cyfinfaza/WINLAB-LP-Radio-Sensor-Hub/WINLAB-LP-Radio-Sensor-Hub-Top-Orthographic.png

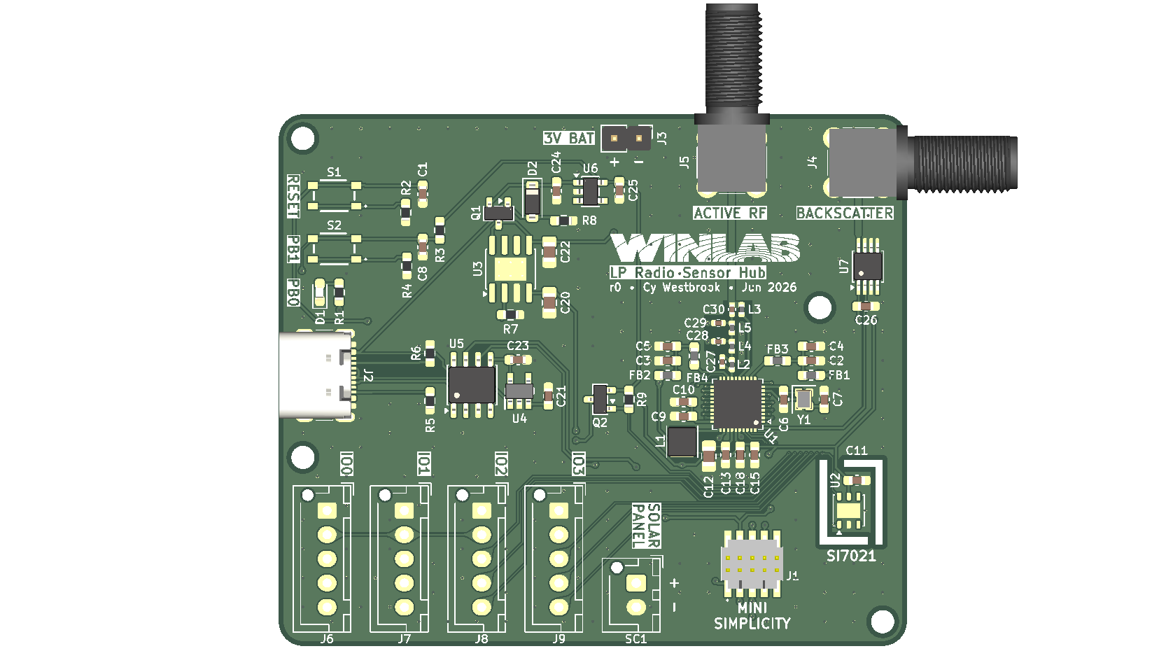
WINLAB-LP-Radio-Sensor-Hub-Top-Orthographic.png
