cyfinfaza/WINLAB-LP-Radio-Sensor-Hub/JLCPCB-BOM.xls

Comment | Designator | Footprint | JLCPCB Part #
1.3n | L4 | 0402 | C97996
470n | C3 | 0603 | C1623
4.7u | C12,C22 | 0805 | C1779
1.5n | L2 | 0402 | C395055
22u | C20 | 0805 | C45783
ADG902BRMZ | U7 | MSOP-8_3x3mm_P0.65mm | C207407
36k | R7,R8,R9 | 0603 | C23147
100n | C1,C11,C13,C15,C26,C8,C9, C17, C19 | 0603 | C14663
FTSH-105-01-L-DV-K-A | J1 | FTSH-105-XX-YYY-DV-K-A | C21221592
100p | C4,C5 | 0603 | C14858
12p | C6,C7 | 0603 | C38523
18n | L3 | 0402 | C86060
AO3401A | Q1,Q2 | SOT-23 | C15127
LED | D1 | 0603 | C2290
13n | L5 | 0402 | C2991840
39MHz10pF | Y1 | Crystal_SMD_2016-4Pin_2.0x1.6mm | C5360883
USB_C_Receptacle_USB2.0_16P | J2 | USB_C_Receptacle_GCT_USB4105-xx-A_16P_TopMnt_Horizontal | C165948
FerriteBead | FB1,FB2,FB3,FB4 | 0603 | C88984
1.9p | C27 | 0402 | C161314
1.3p | C29 | 0402 | C161309
CH340N | U5 | JEITA_SOIC-8_3.9x4.9mm_P1.27mm | C2977777
CN3063 | U3 | SOIC-8-1EP_3.9x4.9mm_P1.27mm_EP2.41x3.3mm_ThermalVias | C28078
5.1k | R5,R6 | 0603 | C23186
220p | C30 | 0402 | C1530
100 | R2,R4 | 0603 | C22775
TPS7A0522PDBV | U6 | SOT-23-5 | C2863529
7.2p | C28 | 0402 | C2220960
1u | C10,C18,C2,C21,C23,C24,C25, C14, C16 | 0603 | C15849
1N4148W | D2 | D_SOD-123 | C81598
10k | R3 | 0603 | C25804
2.2u | L1 | L_APV_ANR3015 | C6364793
470 | R1 | 0603 | C23179
SMA | J4,J5 | SMA | C7542042
Tactile Switch | S1,S2 | RKB2SJK250SMTRLFS | C2927789
TLV74033PDBVR | U4 | TLV74033PDBVR | C3743587
