cyfinfaza/WINLAB-LP-Radio-Sensor-Hub/WINLAB-LP-Radio-Sensor-Hub.kicad_pcb

## KiCad design WINLAB-LP-Radio-Sensor-Hub.kicad_pcb (2026-09-07)

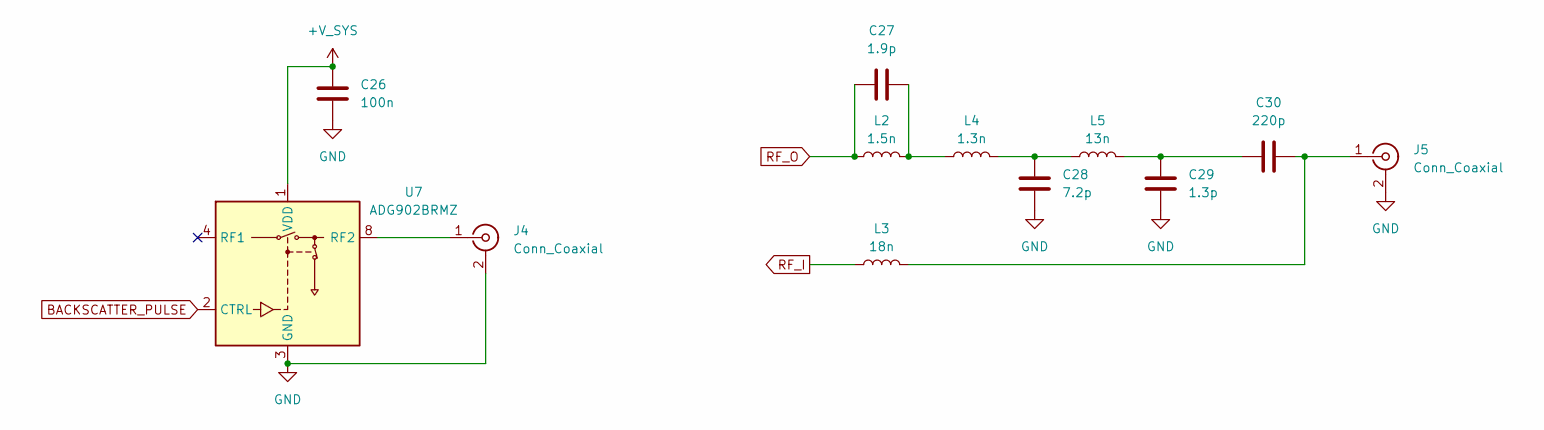
[picture p6: schematic RF.kicad_sch]

Parts:
C26: 100n; C_0603_1608Metric_Pad1.08x0.95mm_HandSolder
C27: 1.9p; C_0402_1005Metric
C28: 7.2p; C_0402_1005Metric
C29: 1.3p; C_0402_1005Metric
C30: 220p; C_0402_1005Metric
J4, J5: Conn_Coaxial; SMA_Molex_73251-2200_Horizontal
L2: 1.5n; L_0402_1005Metric
L3: 18n; L_0402_1005Metric
L4: 1.3n; L_0402_1005Metric
L5: 13n; L_0402_1005Metric
U7: ADG902BRMZ; MSOP-8_3x3mm_P0.65mm

Connections:
+V_SYS: C26.1, U7.1 (VDD); also elsewhere on the board
BACKSCATTER_PULSE: U7.2 (CTRL); also elsewhere on the board
GND: C26.2, C28.2, C29.2, J4.2 (Ext), J5.2 (Ext), U7.3 (GND), U7.5 (GND), U7.6 (GND), U7.7 (GND); also elsewhere on the board
unnamed: C27.2, L2.2, L4.1
unnamed: C28.1, L4.2, L5.1
unnamed: C29.1, C30.1, L5.2
unnamed: J4.1 (In), U7.8 (RF2)
unnamed: C30.2, J5.1 (In), L3.2
RF_I: L3.1; also elsewhere on the board
RF_O: C27.1, L2.1; also elsewhere on the board

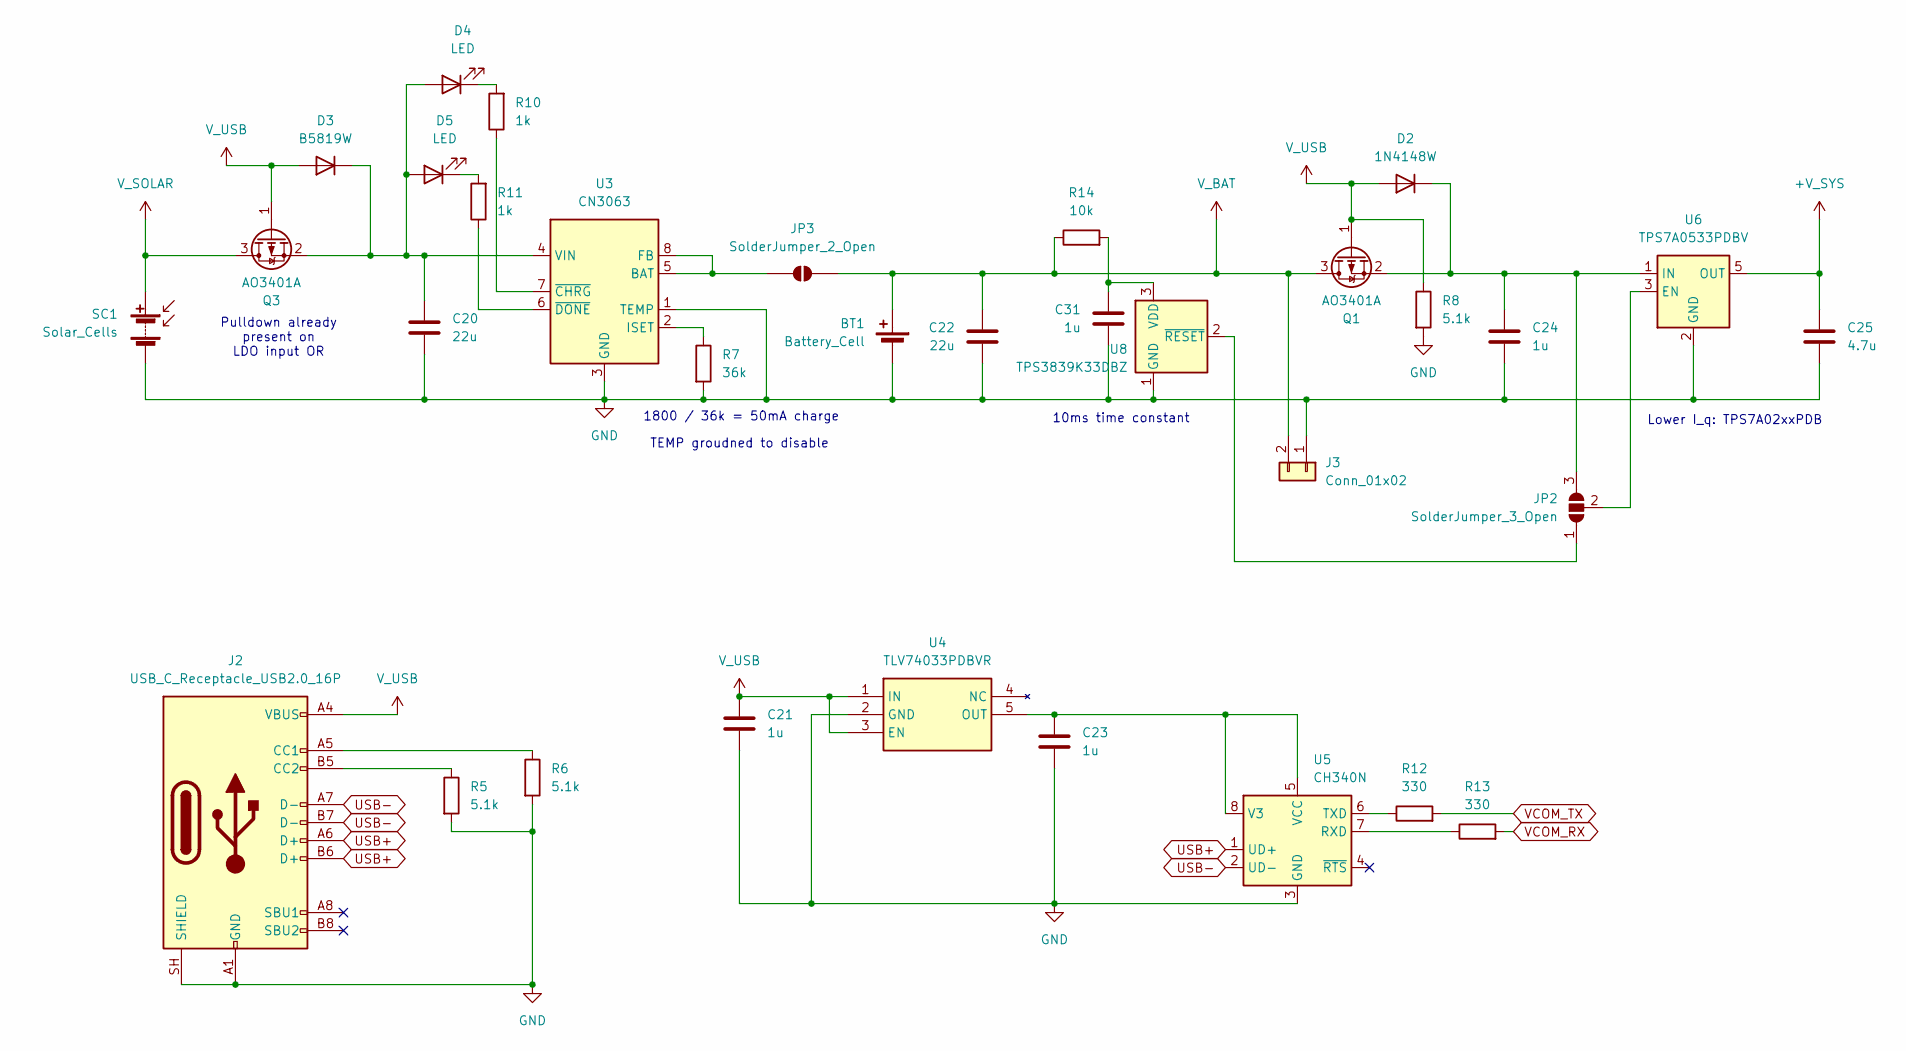
[picture p7: schematic Power.kicad_sch]

Parts:
BT1: Battery_Cell; BatteryHolder_Keystone_3008_1x2450
C20, C22: 22u; C_0805_2012Metric_Pad1.18x1.45mm_HandSolder
C21, C23, C24, C31: 1u; C_0603_1608Metric_Pad1.08x0.95mm_HandSolder
C25: 4.7u; C_0805_2012Metric_Pad1.18x1.45mm_HandSolder
D2: 1N4148W; D_SOD-123
D3: B5819W; D_SOD-123
D4, D5: LED; LED_0603_1608Metric_Pad1.05x0.95mm_HandSolder
J2: USB_C_Receptacle_USB2.0_16P; USB_C_Receptacle_GCT_USB4105-xx-A_16P_TopMnt_Horizontal
J3: Conn_01x02; PinHeader_1x02_P2.54mm_Vertical
JP2: SolderJumper_3_Open; SolderJumper-3_P1.3mm_Open_RoundedPad1.0x1.5mm
JP3: SolderJumper_2_Open; SolderJumper-2_P1.3mm_Open_RoundedPad1.0x1.5mm
Q1, Q3: AO3401A; SOT-23
R5, R6, R8: 5.1k; R_0603_1608Metric_Pad0.98x0.95mm_HandSolder
R7: 36k; R_0603_1608Metric_Pad0.98x0.95mm_HandSolder
R10, R11: 1k; R_0603_1608Metric_Pad0.98x0.95mm_HandSolder
R12, R13: 330; R_0603_1608Metric_Pad0.98x0.95mm_HandSolder
R14: 10k; R_0603_1608Metric_Pad0.98x0.95mm_HandSolder
SC1: Solar_Cells; JST_XH_B2B-XH-AM_1x02_P2.50mm_Vertical
U3: CN3063; SOIC-8-1EP_3.9x4.9mm_P1.27mm_EP2.41x3.3mm_ThermalVias
U4: TLV74033PDBVR; SOT95P280X145-5N; Mouser Part Number 595-TLV74033PDBVR
U5: CH340N; JEITA_SOIC-8_3.9x4.9mm_P1.27mm
U6: TPS7A0533PDBV; SOT-23-5
U8: TPS3839K33DBZ; SOT-23

Connections:
+V_SYS: C25.1, U6.5 (OUT); also elsewhere on the board
GND: BT1.2 (-), C20.2, C21.2, C22.2, C23.2, C24.2, C25.2, C31.2, J2.A1 (GND), J2.A12 (GND), J2.B1 (GND), J2.B12 (GND), J2.SH (SHIELD), J3.1, R5.2, R6.2, R7.2, R8.2, SC1.2 (-), U3.1 (TEMP), U3.3 (GND), U3.9 (GND), U4.2 (GND), U5.3 (GND), U6.2 (GND), U8.1 (GND); also elsewhere on the board
unnamed: C24.1, D2.1 (K), JP2.3 (B), Q1.2 (S), U6.1 (IN)
unnamed: C20.1, D3.1 (K), D4.2 (A), D5.2 (A), Q3.2 (S), U3.4 (VIN)
unnamed: D4.1 (K), R10.2
unnamed: D5.1 (K), R11.2
unnamed: J2.A5 (CC1), R6.1
unnamed: J2.B5 (CC2), R5.1
unnamed: JP2.1 (A), U8.2 (~RESET)
unnamed: JP2.2 (C), U6.3 (EN)
unnamed: JP3.1 (A), U3.5 (BAT), U3.8 (FB)
unnamed: R7.1, U3.2 (ISET)
unnamed: R10.1, U3.7 (~CHRG)
unnamed: R11.1, U3.6 (~DONE)
unnamed: C23.1, U4.5 (OUT), U5.5 (VCC), U5.8 (V3)
unnamed: R13.1, U5.7 (RXD)
unnamed: R12.1, U5.6 (TXD)
unnamed: C31.1, R14.2, U8.3 (VDD)
USB+: J2.A6 (D+), J2.B6 (D+), U5.1 (UD+)
USB-: J2.A7 (D-), J2.B7 (D-), U5.2 (UD-)
VCOM_RX: R13.2; also elsewhere on the board
VCOM_TX: R12.2; also elsewhere on the board
V_BAT: BT1.1 (+), C22.1, J3.2, JP3.2 (B), Q1.3 (D), R14.1
V_SOLAR: Q3.3 (D), SC1.1 (+)
V_USB: C21.1, D2.2 (A), D3.2 (A), J2.A4 (VBUS), J2.A9 (VBUS), J2.B4 (VBUS), J2.B9 (VBUS), Q1.1 (G), Q3.1 (G), R8.1, U4.1 (IN), U4.3 (EN)

Notes on the sheet:
Pulldown already present on LDO input OR
1800 / 36k = 50mA charge
Lower I_q: TPS7A02xxPDB
10ms time constant
TEMP groudned to disable

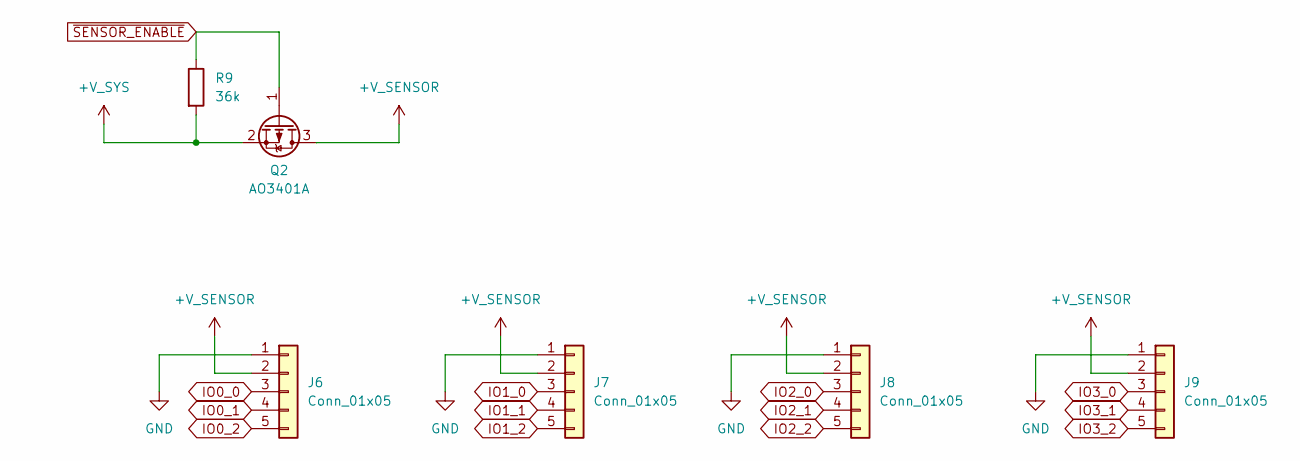
[picture p8: schematic IO.kicad_sch]

Parts:
J6, J7, J8, J9: Conn_01x05; JST_XH_B5B-XH-AM_1x05_P2.50mm_Vertical
Q2: AO3401A; SOT-23
R9: 36k; R_0603_1608Metric_Pad0.98x0.95mm_HandSolder

Connections:
+V_SENSOR: J6.2, J7.2, J8.2, J9.2, Q2.3 (D)
+V_SYS: Q2.2 (S), R9.2; also elsewhere on the board
GND: J6.1, J7.1, J8.1, J9.1; also elsewhere on the board
IO0_0: J6.3; also elsewhere on the board
IO0_1: J6.4; also elsewhere on the board
IO0_2: J6.5; also elsewhere on the board
IO1_0: J7.3; also elsewhere on the board
IO1_1: J7.4; also elsewhere on the board
IO1_2: J7.5; also elsewhere on the board
IO2_0: J8.3; also elsewhere on the board
IO2_1: J8.4; also elsewhere on the board
IO2_2: J8.5; also elsewhere on the board
IO3_0: J9.3; also elsewhere on the board
IO3_1: J9.4; also elsewhere on the board
IO3_2: J9.5; also elsewhere on the board
~SENSOR_ENABLE: Q2.1 (G), R9.1; also elsewhere on the board

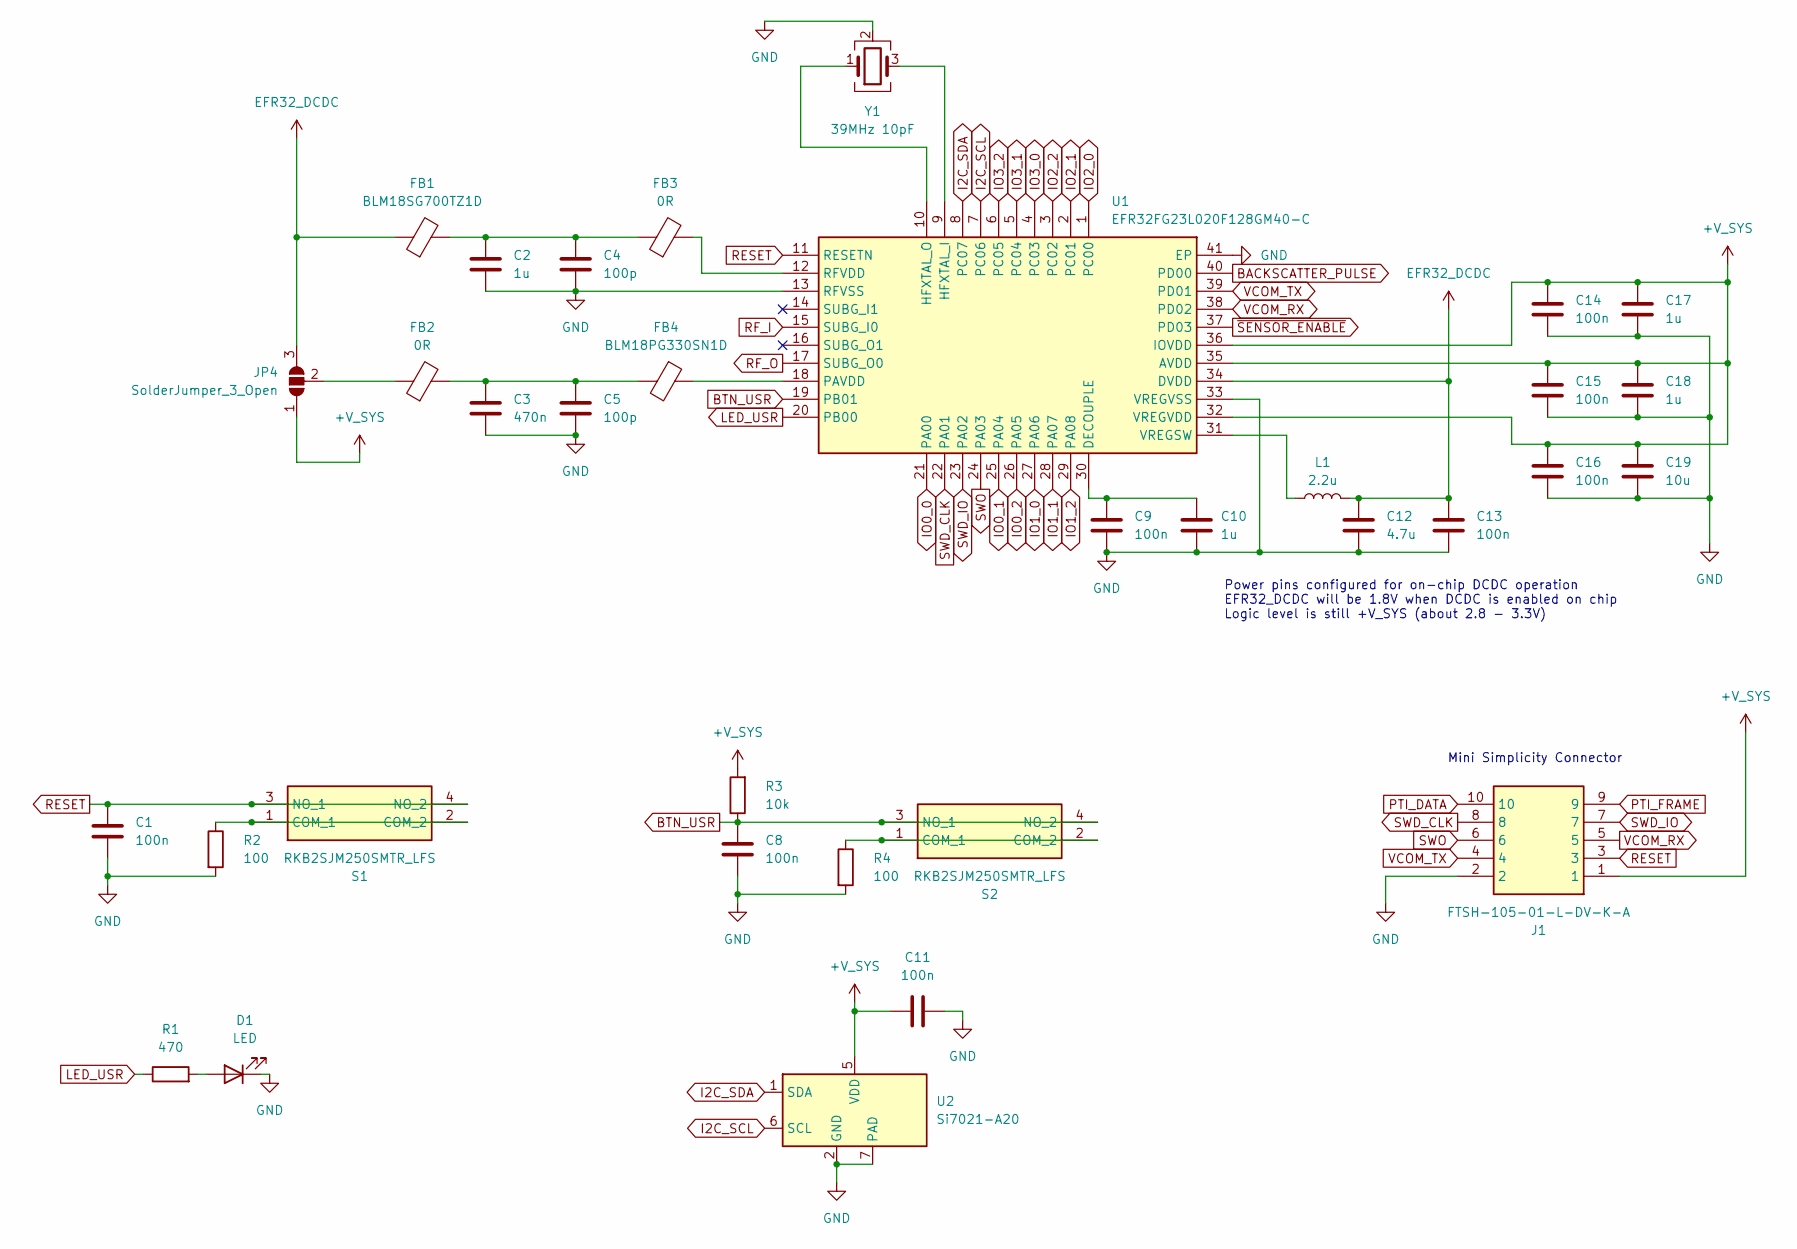
[picture p9: schematic MCU.kicad_sch]

Parts:
C1, C8, C9, C11, C13, C14, C15, C16: 100n; C_0603_1608Metric_Pad1.08x0.95mm_HandSolder
C2, C10, C17, C18: 1u; C_0603_1608Metric_Pad1.08x0.95mm_HandSolder
C3: 470n; C_0603_1608Metric_Pad1.08x0.95mm_HandSolder
C4, C5: 100p; C_0603_1608Metric_Pad1.08x0.95mm_HandSolder
C12: 4.7u; C_0805_2012Metric_Pad1.18x1.45mm_HandSolder
C19: 10u; C_0603_1608Metric_Pad1.08x0.95mm_HandSolder
D1: LED; LED_0603_1608Metric_Pad1.05x0.95mm_HandSolder
FB1: BLM18SG700TZ1D; L_0603_1608Metric_Pad1.05x0.95mm_HandSolder
FB2, FB3: 0R; L_0603_1608Metric_Pad1.05x0.95mm_HandSolder
FB4: BLM18PG330SN1D; L_0603_1608Metric_Pad1.05x0.95mm_HandSolder
J1: FTSH-105-01-L-DV-K-A; FTSH-105-XX-YYY-DV-K-A; Mouser Part Number 200-FTSH10501LDVKA
JP4: SolderJumper_3_Open; SolderJumper-3_P1.3mm_Open_RoundedPad1.0x1.5mm
L1: 2.2u; L_APV_ANR3015
R1: 470; R_0603_1608Metric_Pad0.98x0.95mm_HandSolder
R2, R4: 100; R_0603_1608Metric_Pad0.98x0.95mm_HandSolder
R3: 10k; R_0603_1608Metric_Pad0.98x0.95mm_HandSolder
S1, S2: RKB2SJM250SMTR_LFS; RKB2SJM250SMTRLFS; Mouser Part Number 611-RKB2SJM250SMTRLF
U1: EFR32FG23L020F128GM40-C; QFN-40-1EP_5x5mm_P0.4mm_EP3.6x3.6mm; Manufacturer_Part_Number EFR32FG23L020F128GM40-C
U2: Si7021-A20; DFN-6-1EP_3x3mm_P1mm_EP1.5x2.4mm
Y1: 39MHz 10pF; Crystal_SMD_2016-4Pin_2.0x1.6mm

Connections:
+V_SYS: C11.1, C14.1, C15.1, C16.1, C17.1, C18.1, C19.1, J1.1, JP4.1 (A), R3.2, U1.32 (VREGVDD), U1.35 (AVDD), U1.36 (IOVDD), U2.5 (VDD); also elsewhere on the board
BACKSCATTER_PULSE: U1.40 (PD00); also elsewhere on the board
BTN_USR: C8.1, R3.1, S2.3 (NO_1), S2.4 (NO_2), U1.19 (PB01)
EFR32_DCDC: C12.1, C13.1, FB1.1, JP4.3 (B), L1.2, U1.34 (DVDD)
GND: C1.2, C2.2, C3.2, C4.2, C5.2, C8.2, C9.2, C10.2, C11.2, C12.2, C13.2, C14.2, C15.2, C16.2, C17.2, C18.2, C19.2, D1.1 (K), J1.2, R2.2, R4.2, U1.13 (RFVSS), U1.33 (VREGVSS), U1.41 (EP), U2.2 (GND), U2.7 (PAD), Y1.2 (G), Y1.4 (G); also elsewhere on the board
I2C_SCL: U1.7 (PC06), U2.6 (SCL)
I2C_SDA: U1.8 (PC07), U2.1 (SDA)
IO0_0: U1.21 (PA00); also elsewhere on the board
IO0_1: U1.25 (PA04); also elsewhere on the board
IO0_2: U1.26 (PA05); also elsewhere on the board
IO1_0: U1.27 (PA06); also elsewhere on the board
IO1_1: U1.28 (PA07); also elsewhere on the board
IO1_2: U1.29 (PA08); also elsewhere on the board
IO2_0: U1.1 (PC00); also elsewhere on the board
IO2_1: U1.2 (PC01); also elsewhere on the board
IO2_2: U1.3 (PC02); also elsewhere on the board
IO3_0: U1.4 (PC03); also elsewhere on the board
IO3_1: U1.5 (PC04); also elsewhere on the board
IO3_2: U1.6 (PC05); also elsewhere on the board
LED_USR: R1.1, U1.20 (PB00)
unnamed: C2.1, C4.1, FB1.2, FB3.1
unnamed: C3.1, C5.1, FB2.2, FB4.2
unnamed: D1.2 (A), R1.2
unnamed: FB2.1, JP4.2 (C)
unnamed: R2.1, S1.1 (COM_1), S1.2 (COM_2)
unnamed: R4.1, S2.1 (COM_1), S2.2 (COM_2)
unnamed: C9.1, C10.1, U1.30 (DECOUPLE)
unnamed: U1.9 (HFXTAL_I), Y1.3
unnamed: U1.10 (HFXTAL_O), Y1.1
unnamed: FB4.1, U1.18 (PAVDD)
unnamed: FB3.2, U1.12 (RFVDD)
unnamed: L1.1, U1.31 (VREGSW)
PTI_DATA: J1.10
PTI_FRAME: J1.9
RESET: C1.1, J1.3, S1.3 (NO_1), S1.4 (NO_2), U1.11 (RESETN)
RF_I: U1.15 (SUBG_I0); also elsewhere on the board
RF_O: U1.17 (SUBG_O0); also elsewhere on the board
SWD_CLK: J1.8, U1.22 (PA01)
SWD_IO: J1.7, U1.23 (PA02)
SWO: J1.6, U1.24 (PA03)
VCOM_RX: J1.5, U1.38 (PD02); also elsewhere on the board
VCOM_TX: J1.4, U1.39 (PD01); also elsewhere on the board
~SENSOR_ENABLE: U1.37 (PD03); also elsewhere on the board

Notes on the sheet:
Power pins configured for on-chip DCDC operation EFR32_DCDC will be 1.8V when DCDC is enabled on chip Logic level is still +V_SYS (about 2.8 - 3.3V)
Mini Simplicity Connector

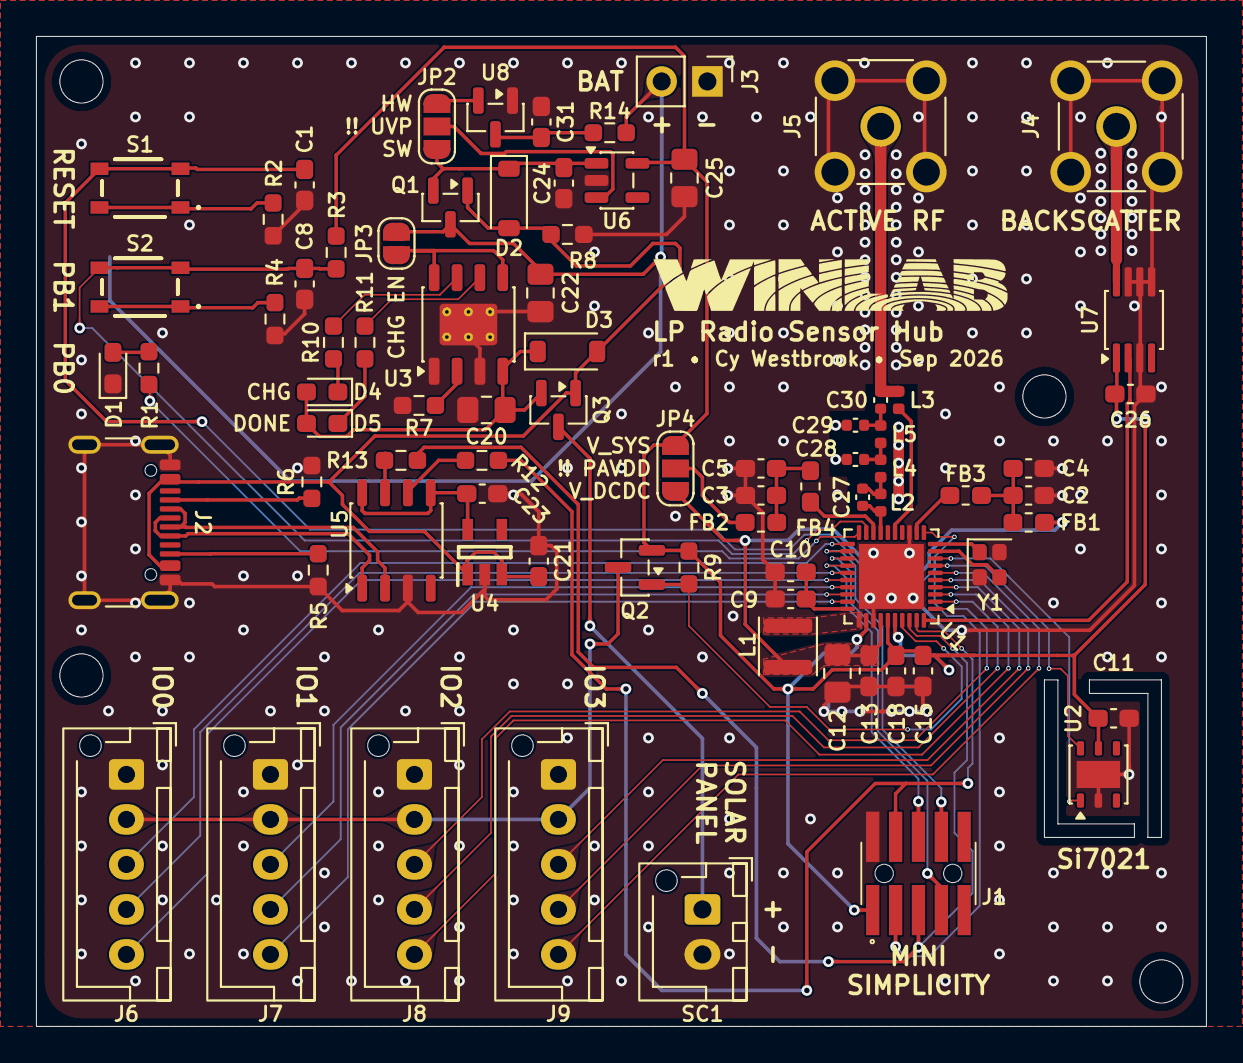
[picture p10: board WINLAB-LP-Radio-Sensor-Hub.kicad_pcb from above]

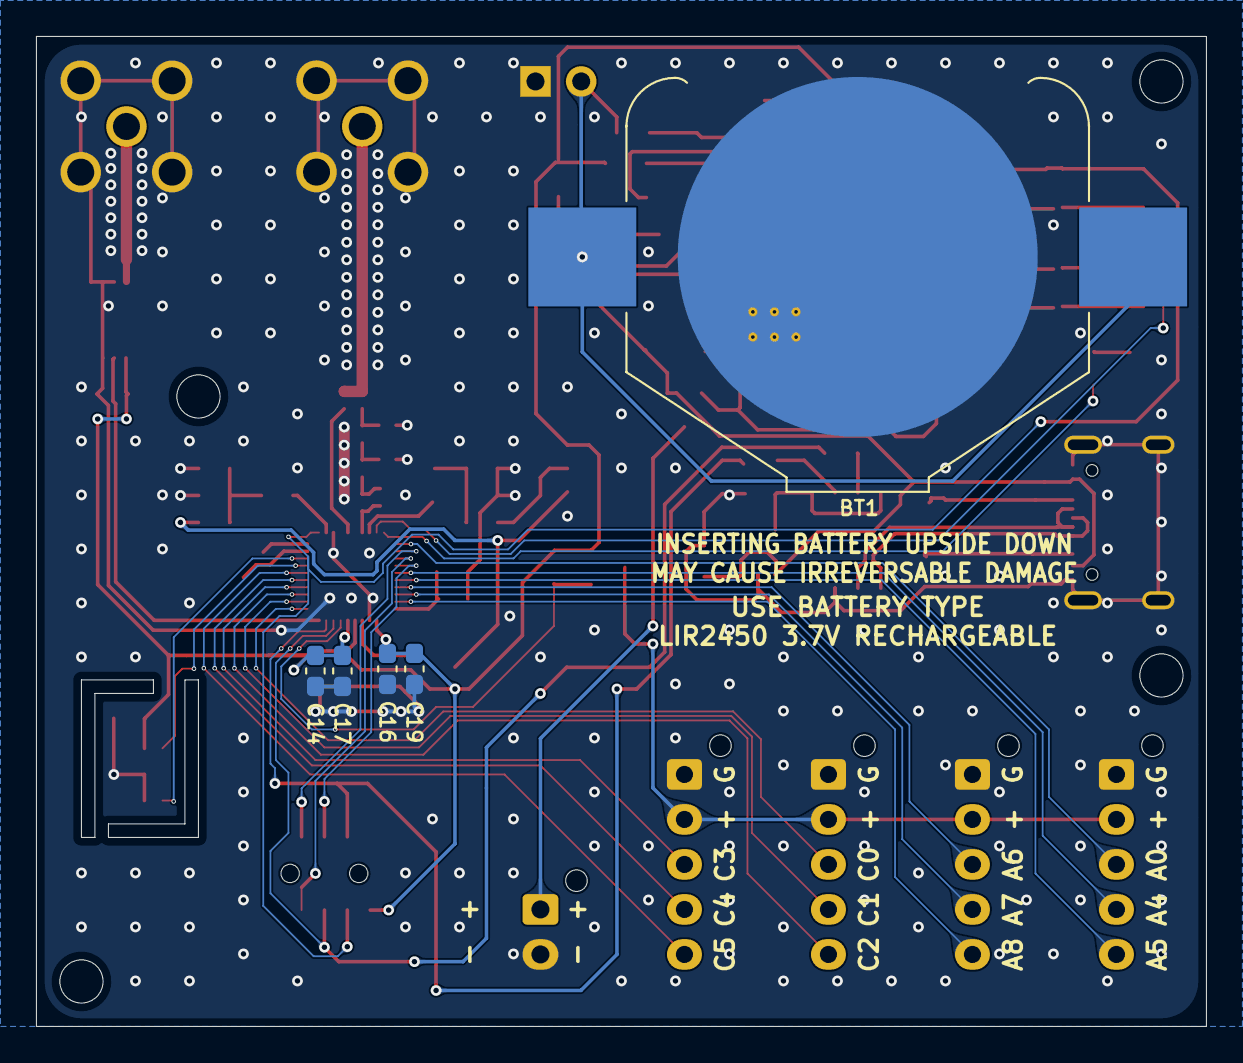
[picture p11: board WINLAB-LP-Radio-Sensor-Hub.kicad_pcb from below]

Board: 2 copper layers, 65.0 x 55.0 mm, 85 parts (5 on the bottom side), 68 nets.
