cyfinfaza/WINLAB-LP-Radio-Sensor-Hub/(commit log)

2026-06-04 debug connector and buttons
    [MCU.kicad_sch]
2026-06-17 add backscatter and active radio components
    [MCU.kicad_sch, RF.kicad_sch, WINLAB-LP-Radio-Sensor-Hub.kicad_sch]
2026-06-18 add initial pinouts and USB
    [MCU.kicad_sch, Power.kicad_sch, RF.kicad_sch]
2026-06-23 add IO ports, begin layout
    [IO.kicad_sch, MCU.kicad_sch, Power.kicad_sch, WINLAB-LP-Radio-Sensor-Hub.kicad_pcb, WINLAB-LP-Radio-Sensor-Hub.kicad_sch]
2026-06-24 minor schematic changes
    [MCU.kicad_sch, Power.kicad_sch, WINLAB-LP-Radio-Sensor-Hub.kicad_pcb]
2026-06-29 initial layout and dense routing near chip
    [Power.kicad_sch, WINLAB-LP-Radio-Sensor-Hub.kicad_pcb]
2026-06-30 more layout and routing work
    [MCU.kicad_sch, WINLAB-LP-Radio-Sensor-Hub.kicad_pcb]
2026-06-30 minor layout tweaks, add external power header
    [Power.kicad_sch, WINLAB-LP-Radio-Sensor-Hub.kicad_pcb]
2026-07-01 completed layout and routing with preliminary matching network
    [IO.kicad_sch, MCU.kicad_sch, Power.kicad_sch, RF.kicad_sch, WINLAB-LP-Radio-Sensor-Hub.kicad_pcb, bom.csv, designators.csv, positions.csv]
2026-07-02 minor layout and silkscreen tweaks
    [WINLAB-LP-Radio-Sensor-Hub.kicad_pcb]
2026-07-02 switch to 0402 matching network closer to reference design
    [RF.kicad_sch, WINLAB-LP-Radio-Sensor-Hub.kicad_pcb]
2026-07-02 via stitching, layout and silkscreen tweaks
    [bom.csv, positions.csv]
2026-07-02 minor tweaks, BOM
    [WINLAB-LP-Radio-Sensor-Hub.csv, WINLAB-LP-Radio-Sensor-Hub.kicad_pcb]
2026-07-03 r0 final
    [WINLAB-LP-Radio-Sensor-Hub.kicad_pcb, designators.csv, positions.csv]
2026-08-12 preliminary JLCPCB BOM, some initial changes for r1
    [JLCPCB-BOM.xls, Power.kicad_sch, WINLAB-LP-Radio-Sensor-Hub.kicad_pcb, positions.csv]
2026-08-13 USB charging, UVP HW supervisor, PAVDD selection, charger IC enable jumper, layout and silkscreen changes
    [MCU.kicad_sch, Power.kicad_sch, WINLAB-LP-Radio-Sensor-Hub.kicad_pcb]
2026-09-01 modify CN3063 footprint to allow routing LED traces under the chip
    [WINLAB-LP-Radio-Sensor-Hub.kicad_pcb]
2026-09-02 add CHG and DONE LEDs for CN3063
    [Power.kicad_sch, WINLAB-LP-Radio-Sensor-Hub.kicad_pcb]
2026-09-03 swap VCOM TX and RX lines on SWD connector (redo routing)
    [WINLAB-LP-Radio-Sensor-Hub.kicad_pcb]
2026-09-07 layout and silkscreen tweaks
    [MCU.kicad_sch, WINLAB-LP-Radio-Sensor-Hub.kicad_pcb]
2026-09-07 change CN3063 input diode and tie temp to ground, HW UVP LPF, change DCDC input capacitance setup, remove crystal loading caps, add series resistors on CH340 serial lines, add via fence on CPWGs
    [MCU.kicad_sch, Power.kicad_sch, WINLAB-LP-Radio-Sensor-Hub.kicad_pcb]
2026-09-08 add LCSC part number properties in preparation for JLCPCB assembly order
    [IO.kicad_sch, MCU.kicad_sch, Power.kicad_sch, RF.kicad_sch, WINLAB-LP-Radio-Sensor-Hub.csv]
